CentroEPiaggio/IPJ-Bio/Mechanics/assembled.jpg

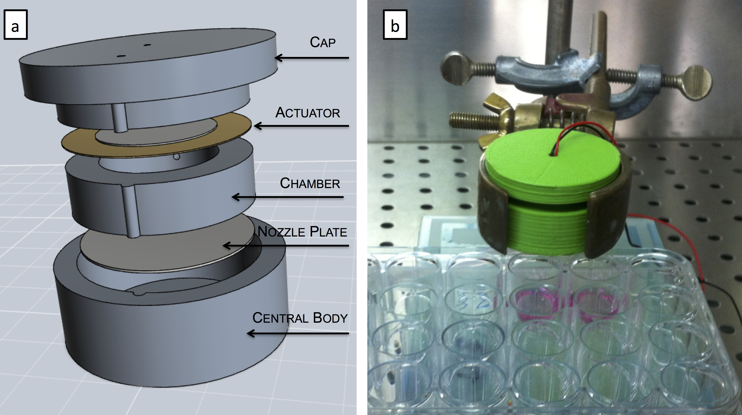
Mechanics/assembled.jpg
