CentroEPiaggio/IPJ-Bio/Electronics/Fig1_MILLEFORI_EAGLE.png

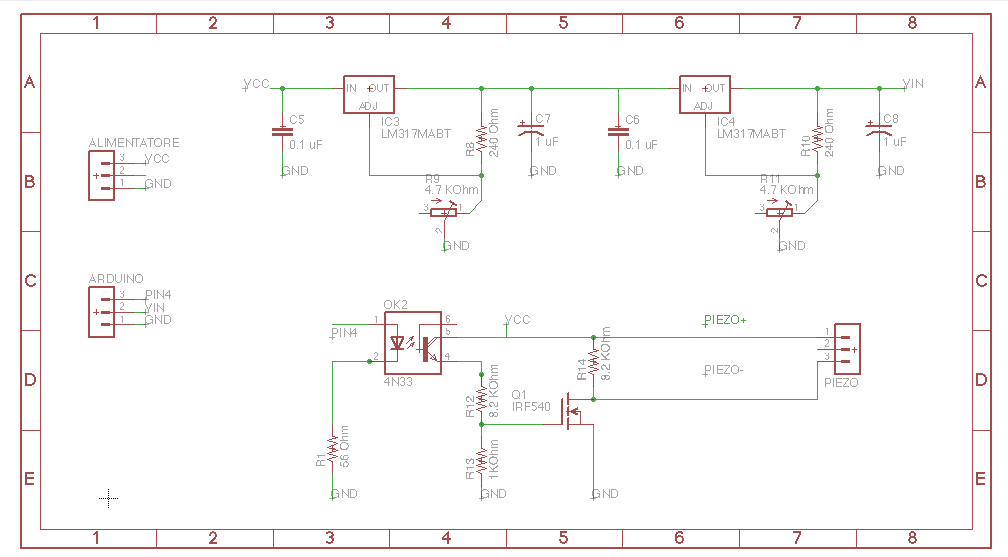
Electronics/Fig1_MILLEFORI_EAGLE.png
