CentroEPiaggio/IPJ-Bio/Mechanics/top.STL

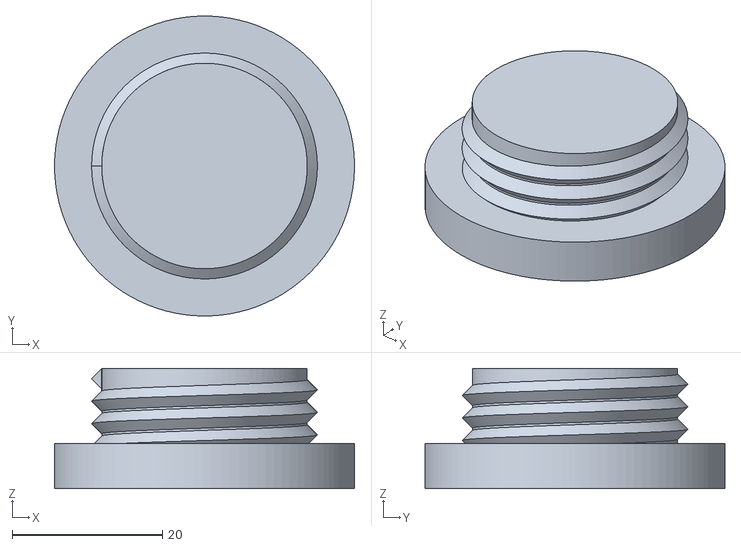
[picture p3: CAD file, 2015-04-30]
Mechanics/top.STL
40.0 x 40.0 x 16.0
