CentroEPiaggio/IPJ-Bio/Mechanics/bottom.STL

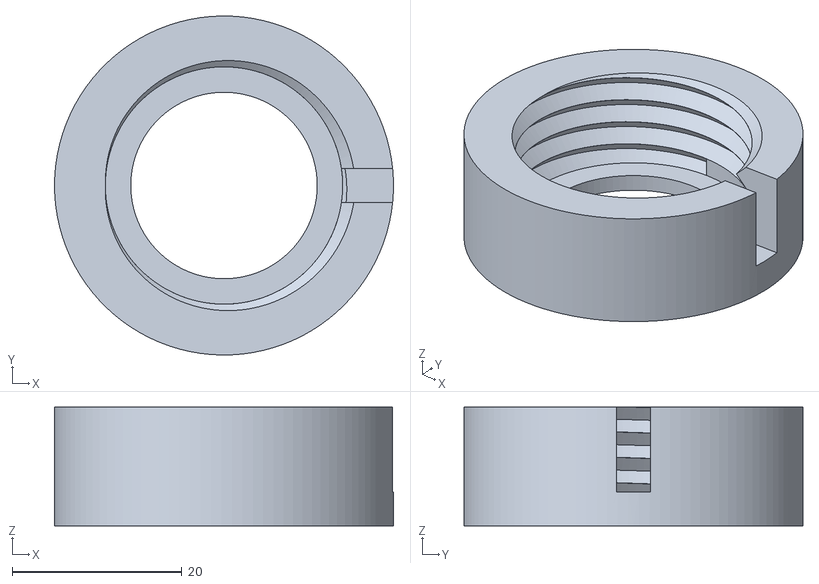
[picture p4: CAD file, 2015-04-30]
Mechanics/bottom.STL
40.0 x 40.0 x 14.0
