CentroEPiaggio/IPJ-Bio/Electronics/Schematic_PCB.sch

## EAGLE design Electronics/Schematic_PCB.sch (2015-04-30)

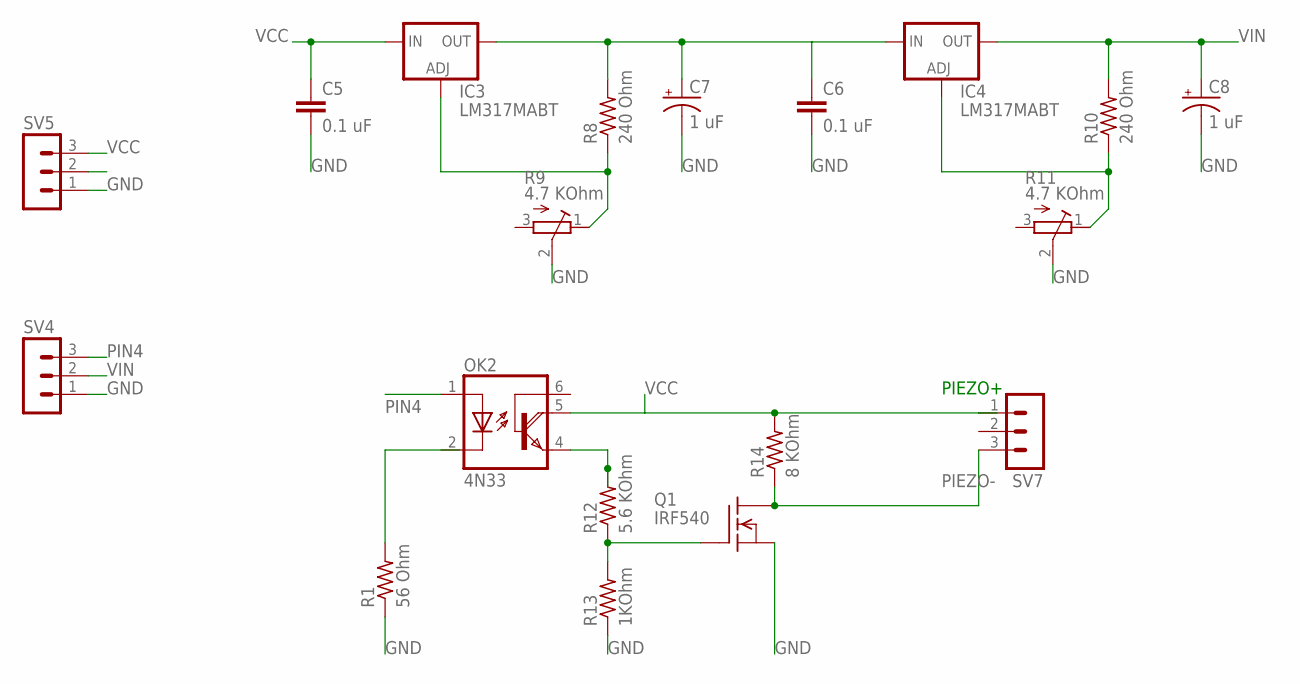
[picture p5: schematic Schematic_PCB.sch]

Parts:
C5, C6: 0.1 uF; C2.5-2
C7, C8: 1 uF; B45181C
IC3, IC4: LM317MABT; TO220L1
OK2: 4N33; DIL06
Q1: IRF540; TO220
R1: 56 Ohm; 0204/5
R8, R10: 240 Ohm; 0204/5
R9, R11: 4.7 KOhm; RTRIM43P
R12: 5.6 KOhm; 0204/5
R13: 1KOhm; 0204/5
R14: 8 KOhm; 0204/5
SV4, SV5, SV7: MA03-1

Connections:
GND: C5.2, C6.2, C7.-, C8.-, Q1.3 (S), R1.1, R9.2 (S), R11.2 (S), R13.1, SV4.1, SV5.1
unnamed: OK2.4 (E), R12.2
unnamed: C7.+, IC3.2 (OUT), R8.2
unnamed: IC4.1 (ADJ), R10.1, R11.1 (E)
unnamed: IC3.1 (ADJ), R8.1, R9.1 (E)
unnamed: Q1.1 (G), R12.1, R13.2
PIEZO-: Q1.2 (D), R14.1, SV7.3
PIN4: OK2.1 (A), SV4.3
VCC: C5.1, C6.1, IC3.3 (IN), IC4.3 (IN), OK2.5 (COL), R14.2, SV5.3, SV7.1
VIN: C8.+, IC4.2 (OUT), R10.2, SV4.2

Notes on the sheet:
PIEZO+
