CentroEPiaggio/IPJ-Bio/(threads)

Thread 1 (2017-04-19):

mechanical. jpeg different from stl

DimitriF, 2017-04-19:
Hello,
I want to make your piezzo inkjet print head and started by printing the stl files,
However, the stl are different from the jpeg file in the directory and what I also saw in the paper.
Could you also add a BOM ??
Dimitri
